virtual-fly/VF_MOTOR_DRIVER/VF_Motor_Driver_rev2/OutputFiles/Assembly/VF_Motor_Driver_BOM.xlsx

Comment | Designator | Footprint | LCSC | Comment | Manufacturer | Reference
74LV17APWJ | U8,U3 | TSSOP-14_4.4x5mm_P0.65mm | C7780 |  | Texas Instruments | SN74LV14APWR
100nF | C27,C18,C25,C26,C65,C56,C57,C55,C9,C23,C66,C17,C24,C28,C54,C34,C59,C29,C43,C4,C67,C35,C53,C40,C30,C60,C12,C48,C6,C68,C58,C36 | C_0603_1608Metric | C14663
ABN Encoder Roll | J7 | JST_PH_B5B-PH-K_1x05_P2.00mm_Vertical | C157993
LM5109BSD | U24,U25,U26,U11,U9,U10 | WSON-8-1EP_4x4mm_P0.8mm_EP2.6x3mm | C544701 |  | Texas Instruments | LM5109BSD/NOPB
MCP1416 | U18,U36 | SOT-23-5 | C83775 |  | Microchip Tech | MCP1416T-E/OT
1.5k | R60,R65,R36,R27,R62,R11 | R_0603_1608Metric | C22843
10uF | C14,C13,C11,C15,C16,C46,C5,C2,C8,C10 | C_0805_2012Metric | C440198
HV>100V | D37 | D_SMA | C5241914 |  | VSSAF5M10-M3/H | VSSAF5M10-M3/H
10k | R1,R37,R38,R15,R53,R44,R54,R40,R43,R42,R29,R16,R24 | R_0603_1608Metric | C25804
0R | R4,R6,R2,R5,R23 | R_0603_1608Metric | C21189 | Mount R23 when using only one brake resistor
ABN Encoder Pitch | J3 | JST_PH_B5B-PH-K_1x05_P2.00mm_Vertical | C157993
BSC030N08NS5ATMA1 | U28,U27,U38,U32,U17,U20,U14,U7,U15,U21,U16,U22,U33,U31,U34,U37 | Infineon_PG-TDSON-8_6.15x5.15mm | C3288905 |  | Infineon Technologies | BSC030N08NS5ATMA1
LV Low Drop | D17,D34,D35,D15,D2 | D_SOD-123F | C130413
LD1117S33TR_SOT223 | U5 | SOT-223-3_TabPin2 | C86781
10uH - LQH43PN100M26L | L1 | L_1812_4532Metric | C99792 |  | Murata Electronics | LQH43PN100M26L
POWER SUPPLY / BRAKE RESISTOR | J6,J2 | JST_VH_B2P-VH-B_1x02_P3.96mm_Vertical |  | 10 A with AWG16 wire. Mating: VHR-2N housing + SVH-41T-P1.1 contacts | JST | B2P-VH-B(LF)(SN)
AP3012KTR-G1 | U2 | SOT-23-5 | C102618
LD1117S50TR_SOT223 | U4 | SOT-223-3_TabPin2 | C134077
Power Led | LED1 | LED_0805_2012Metric | C2297
680uF | C71,C42,C70,C44 | CP_Radial_D16.0mm_P7.50mm | C6611961 |  | PANASONIC | EEU-FS1K681B
ACS724xLCTR-30AB | U29,U13,U12,U30 | SOIC-8_3.9x4.9mm_P1.27mm | C141715 |  | Allegro MicroSystems, LLC | ACS724LLCTR-30AB-T
MOTOR Pitch | J4 | JST_VH_B3P-VH-B_1x03_P3.96mm_Vertical |  | 10 A with AWG16 wire. Mating: VHR-3N housing + SVH-41T-P1.1 contacts | JST | B3P-VH-B(LF)(SN)
220uH | L2 | L_Wurth_WE-LQS-8065 | C86663 |  | Sunlord | SWPA8040S221MT
TMC4671-LA | U23,U1 | QFN76_10P5X6P5_TRI | C465954 | Out of Stock | TRINAMIC Motion Control GmbH | TMC4671-LA
ASCO-25.000MHZ-EK-T3 | Y2,Y1 | Oscillator_SMD_Abracon_ASCO-4Pin_1.6x1.2mm | C7503544
593D(68/47)6X0016D2TE3 | C72 | CP_EIA-7343-31_Kemet-D | C1968403 |  | Vishay Intertech | 593D476X9016D2TE3
MOTOR Roll | J8 | JST_VH_B3P-VH-B_1x03_P3.96mm_Vertical |  | 10 A with AWG16 wire. Mating: VHR-3N housing + SVH-41T-P1.1 contacts | JST | B3P-VH-B(LF)(SN)
MAX5035(D/B)ASA/V+ | U35 | SOIC-8_3.9x4.9mm_P1.27mm | C15940 |  | Analog Devices Inc./Maxim Integrated | MAX5035DASA+T
LV Low drop | D1,D21 | D_SOD-123F | C130413
MCP6004 | U40,U19 | TSSOP-14_4.4x5mm_P0.65mm | C50282
Communication connector | J5 | IDC-Header_2x08_P2.54mm_Vertical | C3406
36k | R34,R51,R30,R52,R25,R33,R55,R63 | R_0603_1608Metric | C103579
1uF | C39,C61,C64,C7,C69,C38,C37,C41,C33 | C_1206_3216Metric | C1848
HV>100V | D12,D29,D11,D19,D28,D13,D30,D3 | D_SOD-123F | C64898
HV>100V | D4 | D_SOD-123F | C604266 |  | onsemi | NRVB1H100SFT3G
10R | R17,R19,R48,R22,R20,R49,R50,R46,R47,R21,R45,R18 | R_0603_1608Metric | C22859
47k | R67,R13,R32 | R_0603_1608Metric | C25819
BZX384-XXX | D14,D18,D32,D16,D33,D31 | D_SOD-323 | C295459
10k thermistor | R26,R61 | R_0603_1608Metric | C525381
4.7uF | C52,C3,C1,C45,C49,C20,C47,C51,C21,C22,C19,C50 | C_0603_1608Metric | C19666
4.7k | R9,R7,R58,R10,R56,R57 | R_0603_1608Metric | C23162
294k | R41,R39,R3 | R_0603_1608Metric | C2999562
D | D27,D10,D5,D22,D7,D9,D23,D8,D6,D25,D24,D26 | D_SOD-123F | C64898
71.5k | R64,R35,R66,R31,R8,R14 | R_0805_2012Metric | C2684592
4.7nF | C62,C31,C32,C63 | C_0603_1608Metric | C53987
LM74700-Q1 | U39,U6 | SOT-23-6 | C2941042
5V | JP2 | R_0805_2012Metric | C17477
15k | R12 | R_0603_1608Metric | C22809
3V3 | JP1 | R_0805_2012Metric | C17477
1M | R68 | R_1206_3216Metric | C17927
100nF 250V | C73 | C_Disc_D7.5mm_W5.0mm_P7.50mm | C342770 |  | TDK | CS45-F2GA103M-VKA
