virtual-fly/VF_MOTOR_DRIVER/VF_Motor_Driver_rev2/OutputFiles/3D/VF_Motor_Driver_rev3.step

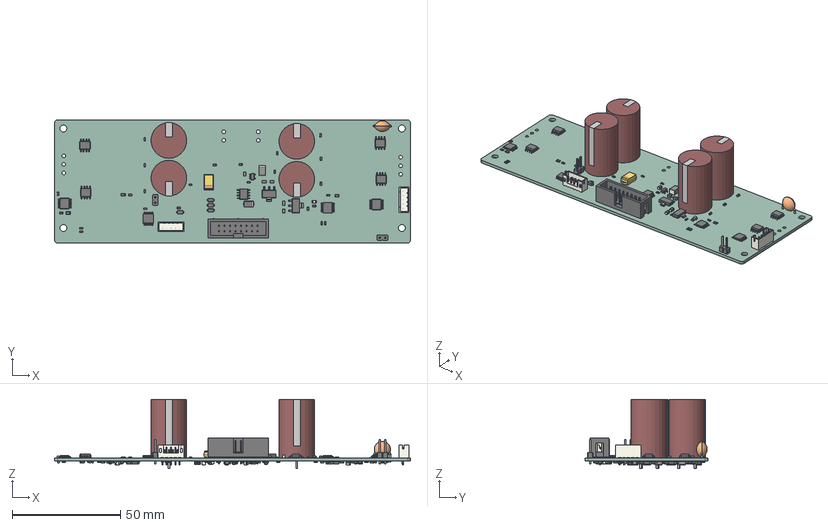
[picture p1: CAD file, 2026-11-05]
VF_Motor_Driver_rev2/OutputFiles/3D/VF_Motor_Driver_rev3.step
164.6 x 57.0 x 32.1 mm
R_0603_1608Metric x 59
JST_PH_B5B-PH-K_1x05_P2.00mm_Vertical x 2
C_0805_2012Metric x 10
D_SMA
C_0603_1608Metric x 48
PinHeader_1x02_P2.54mm_Vertical x 2
TSSOP-14_4.4x5mm_P0.65mm x 4
D_SOD-123F x 28
SOT-223 x 2
L_1812_4532Metric
SOT-23-5 x 3
LED_0805_2012Metric
CAP_EEUFS1K681B_PAN x 4
SOIC-8_3.9x4.9mm_P1.27mm x 5
R_0805_2012Metric x 8
CP_EIA-7343-31_Kemet-D
C_Disc_D7.5mm_W5.0mm_P7.50mm
IDC-Header_2x08_P2.54mm_Vertical
C_1206_3216Metric x 9
D_SOD-323 x 6
R_1206_3216Metric
SOT-23-6 x 2
VF_Motor_Driver_PCB
