virtual-fly/VF_MOTOR_DRIVER/VF_Motor_Driver_rev2/OutputFiles/3D/VF_Motor_Driver_rev2.step

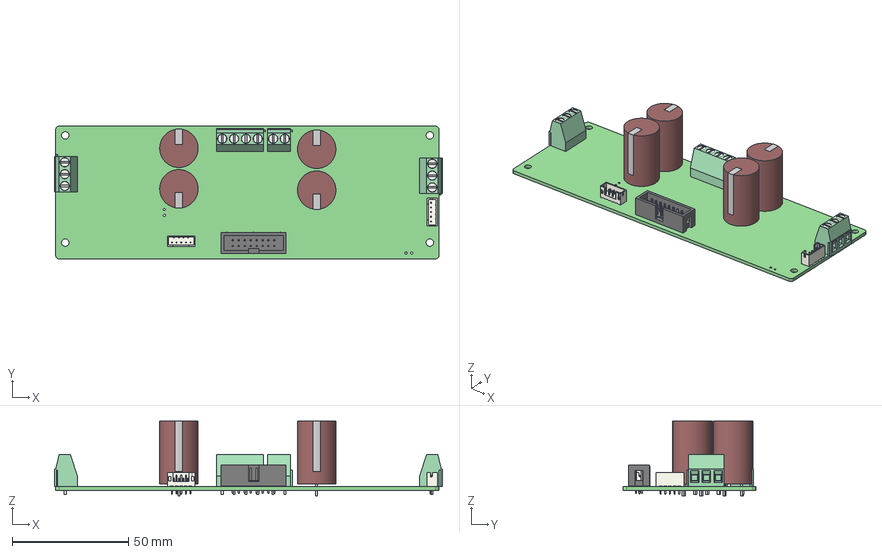
[picture p2: CAD file, 2026-04-09]
VF_Motor_Driver_rev2/OutputFiles/3D/VF_Motor_Driver_rev2.step
166.5 x 57.0 x 32.1 mm
VF_Motor_Driver PCB
