virtual-fly/VF_MOTOR_DRIVER/(list of files, cad)

Other CAD files:
VF_Motor_Driver_rev2/OutputFiles/3D/VF_Motor_Driver_rev2.1.step
