virtual-fly/VF_MOTOR_DRIVER/VF_Motor_Driver_rev2/OutputFiles/FR4_Characteristics.PNG

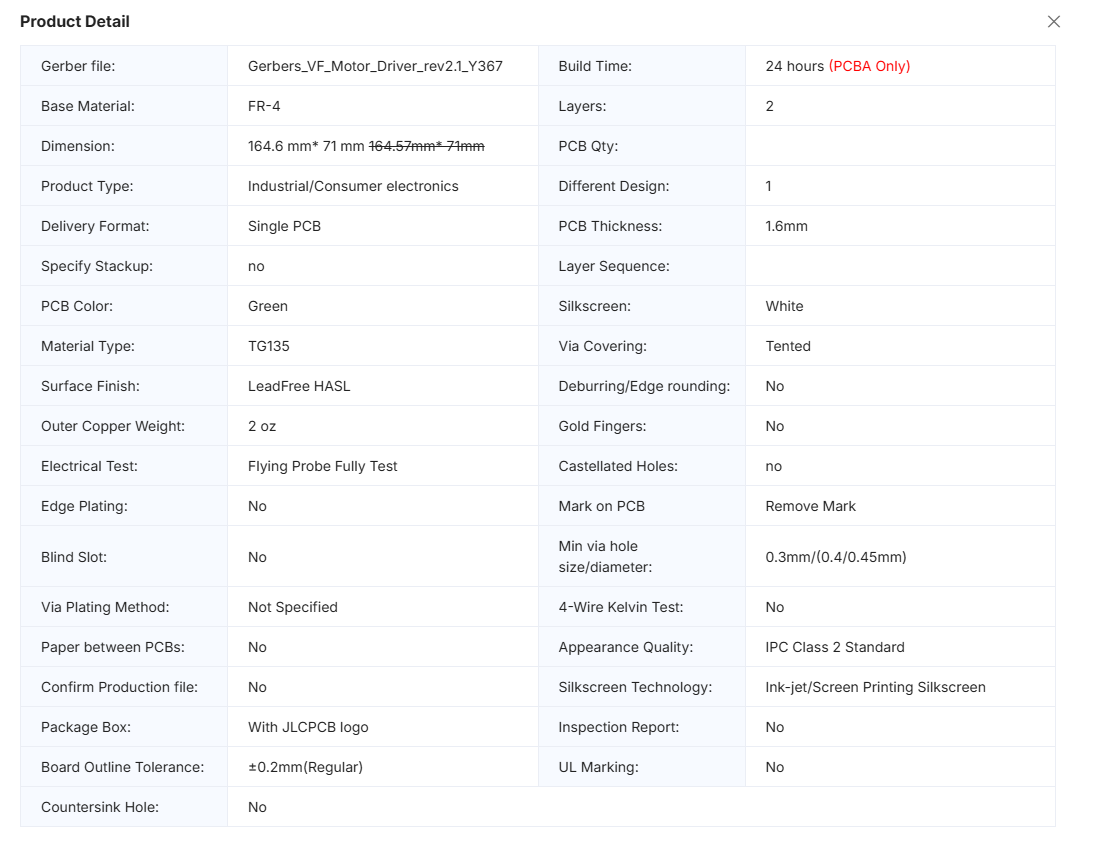
VF_Motor_Driver_rev2/OutputFiles/FR4_Characteristics.PNG
