virtual-fly/VF_MOTOR_DRIVER/VF_Motor_Driver_rev2/OutputFiles/Schematic/VF_Motor_Driver.pdf

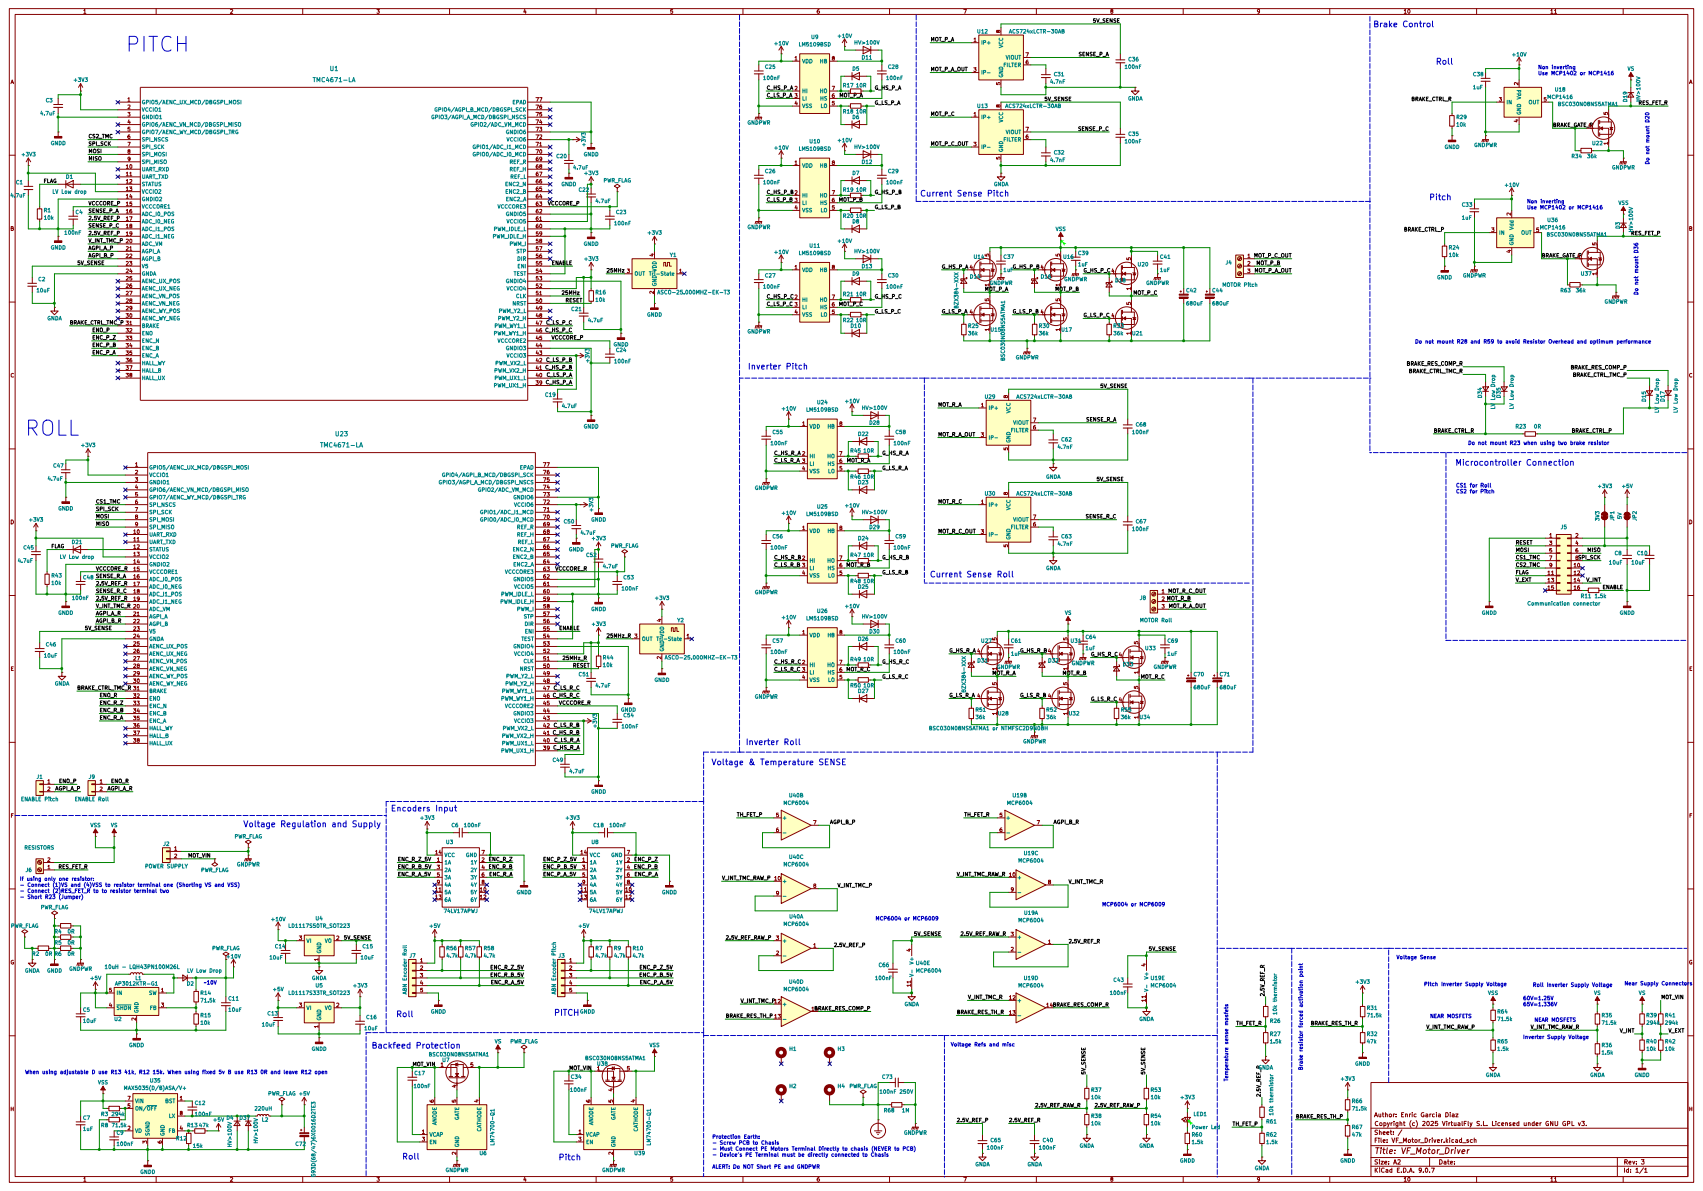
[picture p4: page 1]
