virtual-fly/VF_MOTOR_DRIVER/VF_Motor_Driver_rev2/VF_Motor_Driver.kicad_pcb

## KiCad design VF_Motor_Driver_rev2/VF_Motor_Driver.kicad_pcb (2026-11-05)

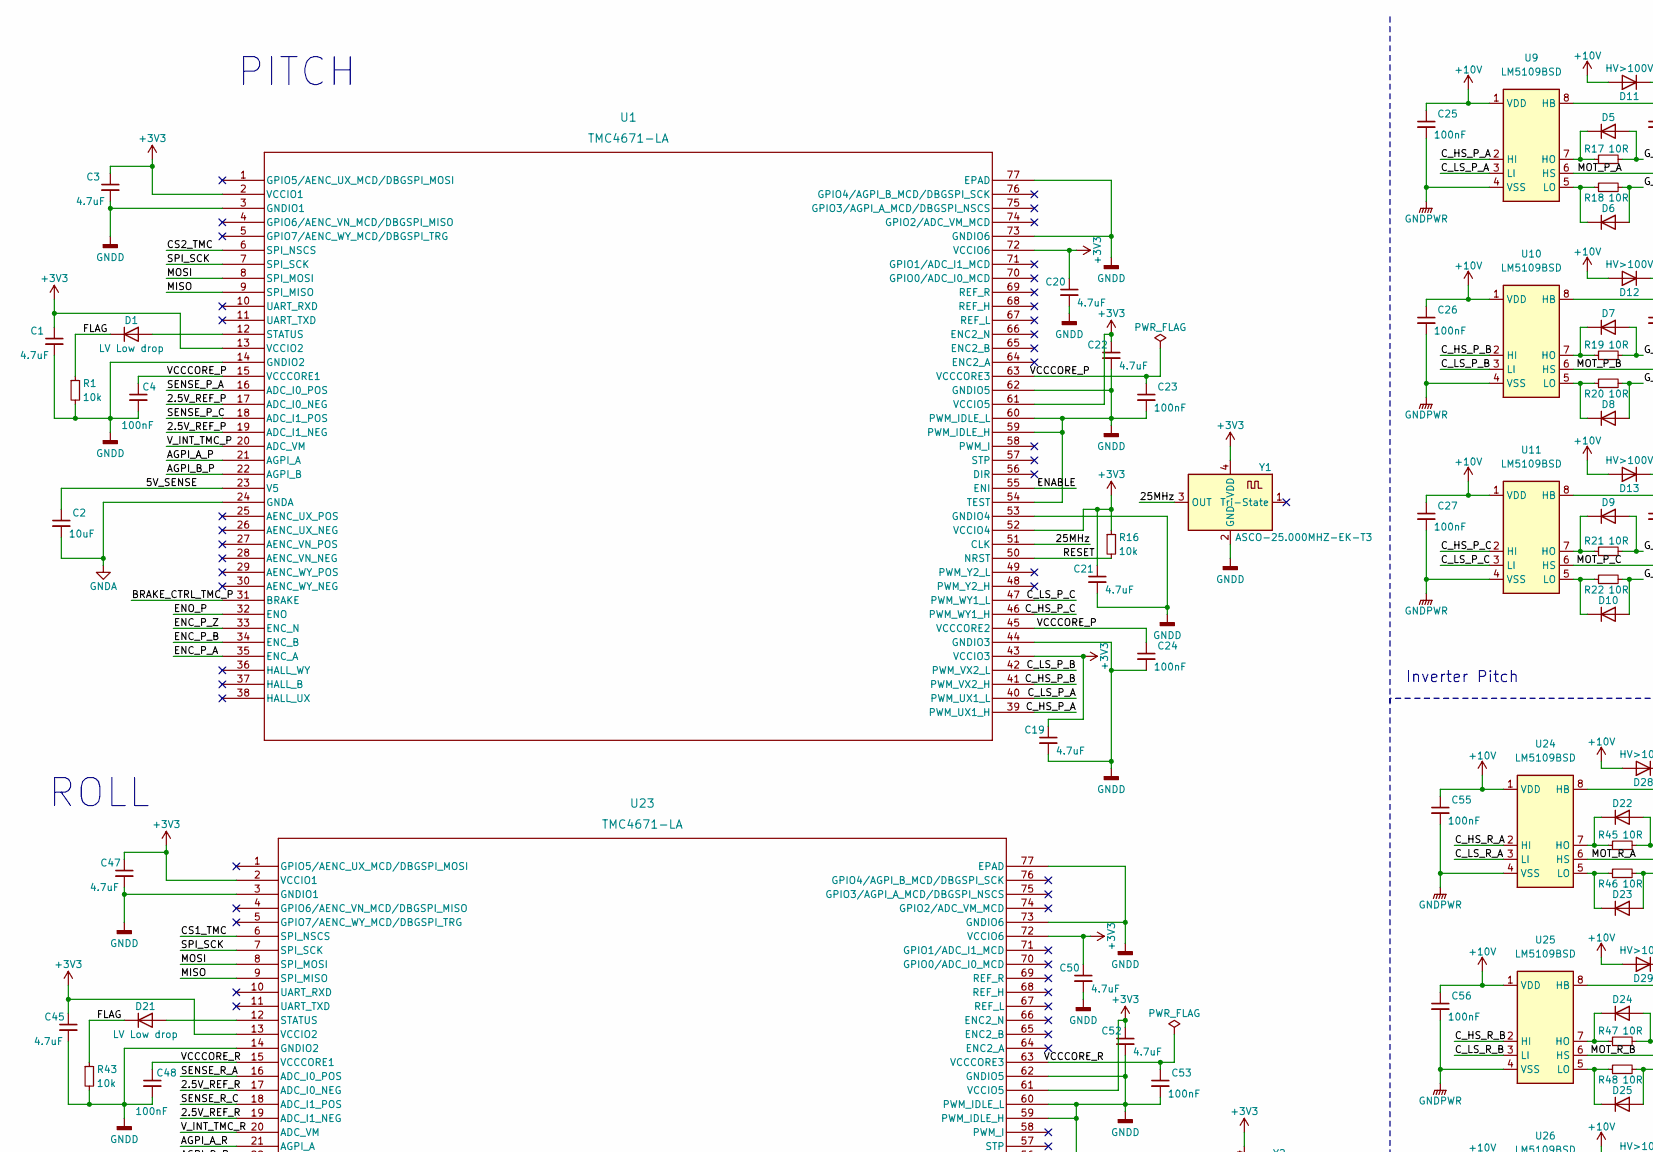
[picture p23: schematic VF_Motor_Driver.kicad_sch, part in row 1, column 1]

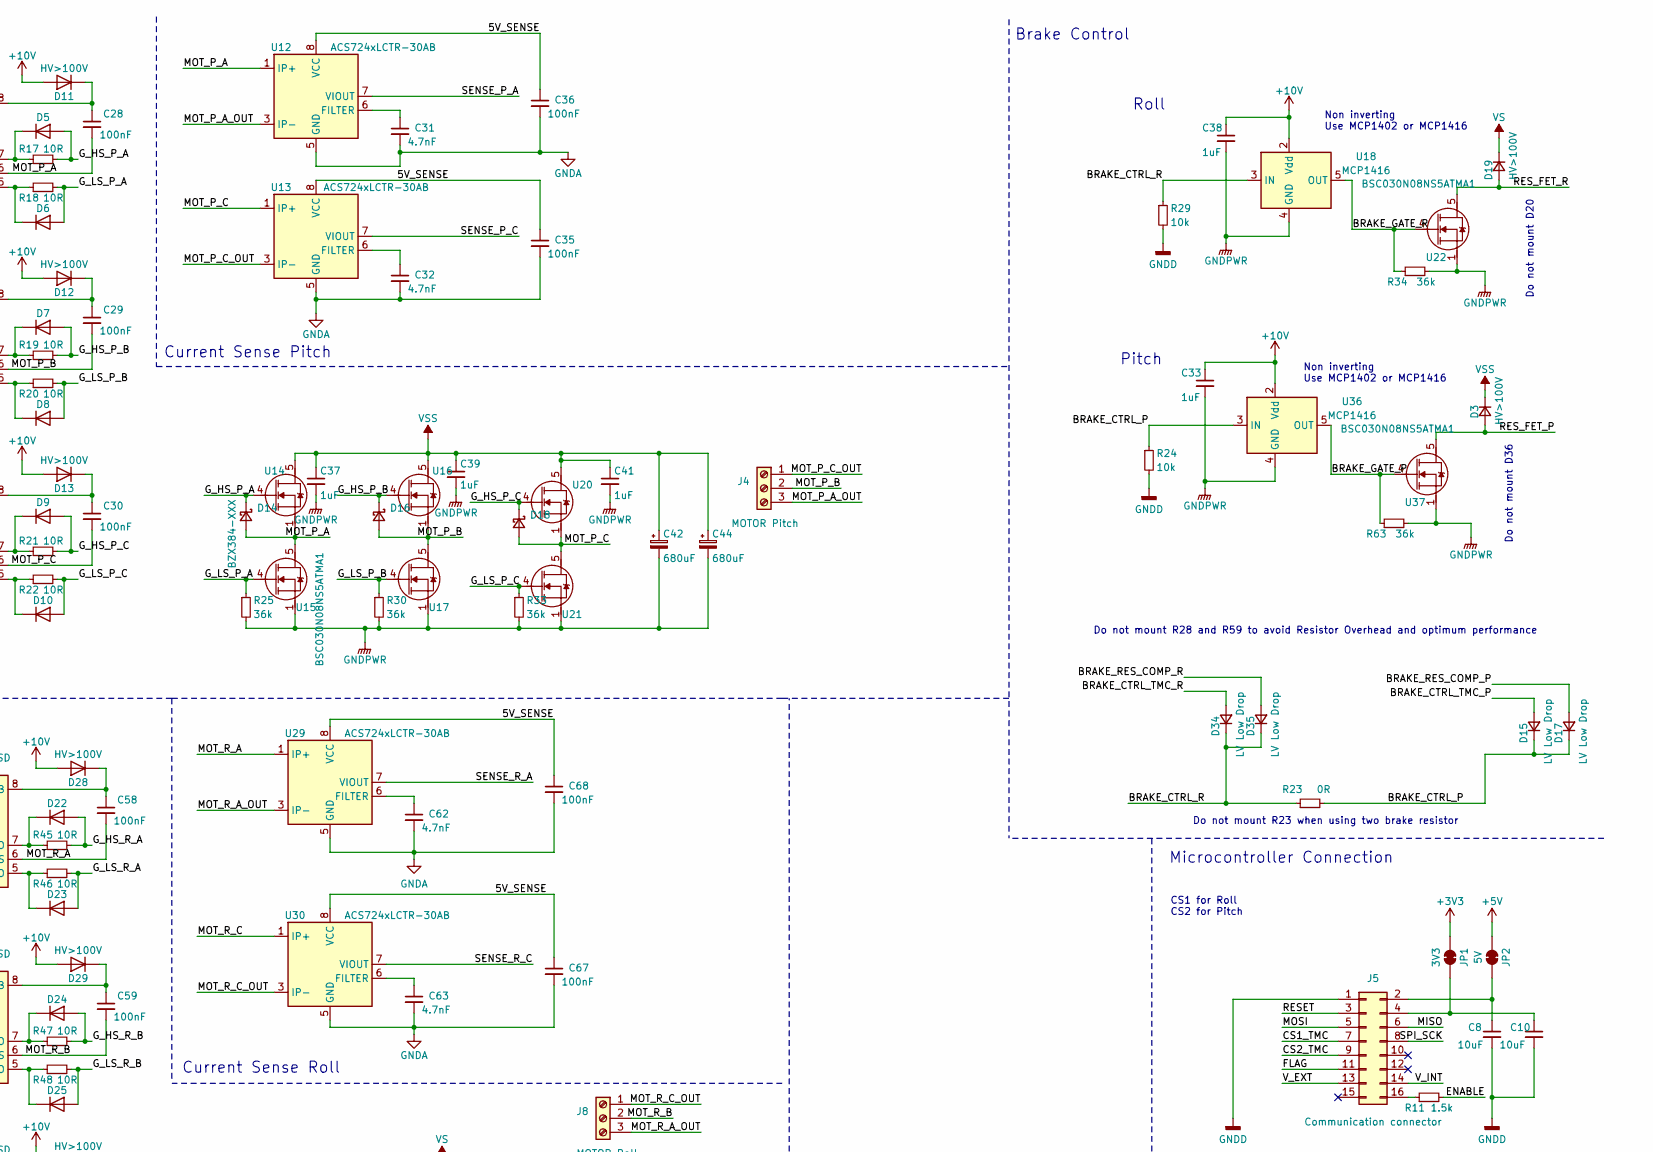
[picture p24: schematic VF_Motor_Driver.kicad_sch, part in row 1, column 2]

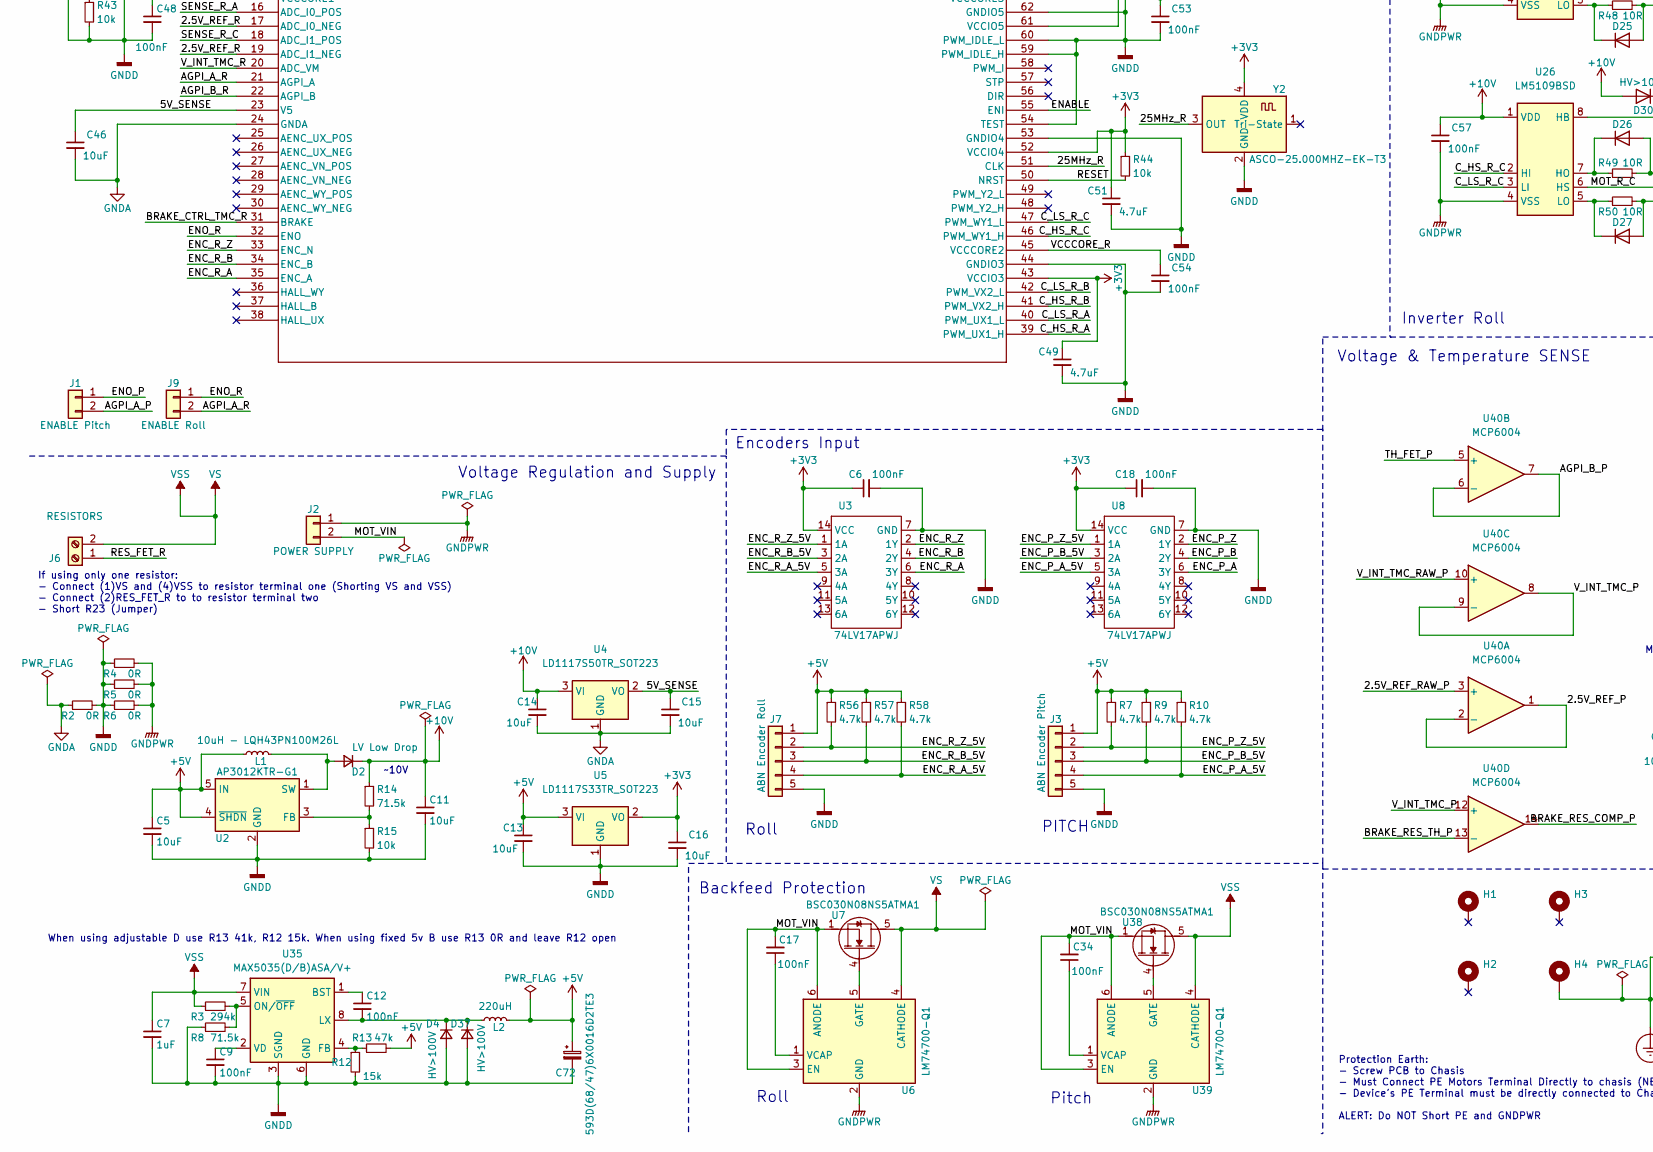
[picture p25: schematic VF_Motor_Driver.kicad_sch, part in row 2, column 1]

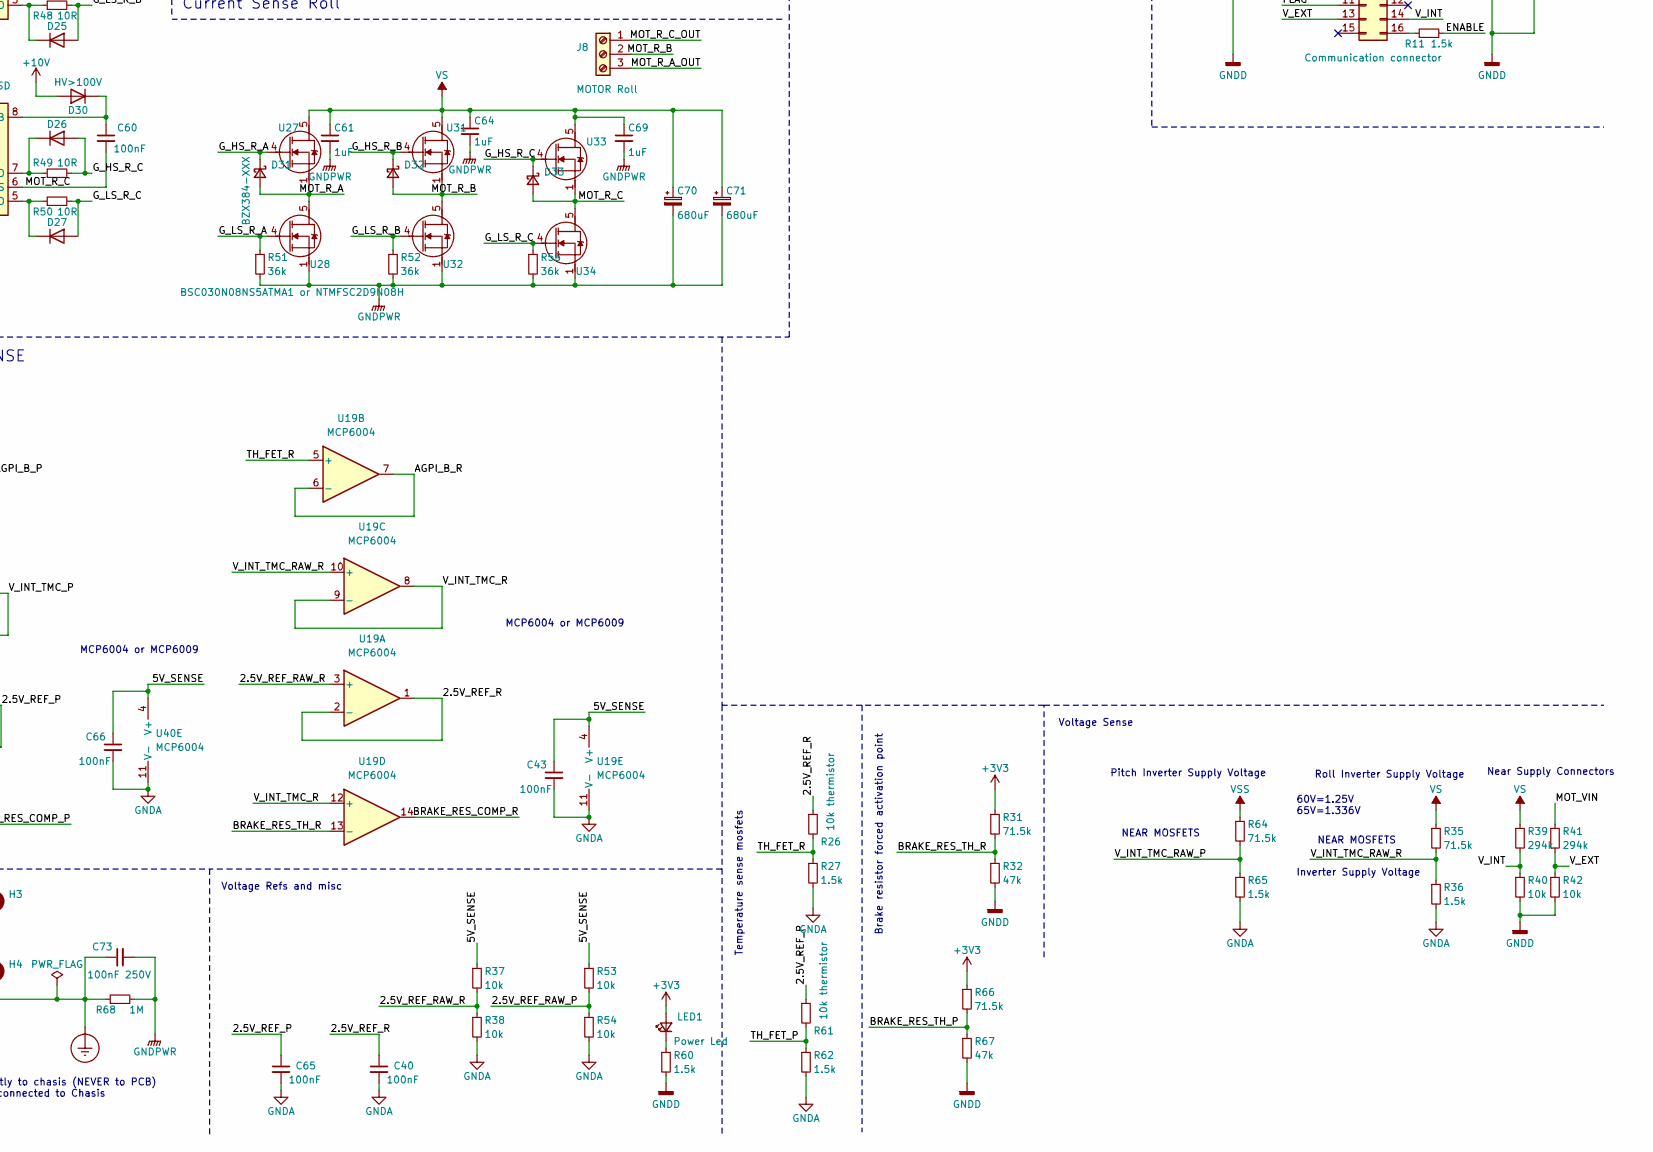
[picture p26: schematic VF_Motor_Driver.kicad_sch, part in row 2, column 2]

Parts:
C1, C3, C19, C20, C21, C22, C45, C47, C49, C50, C51, C52: 4.7uF; C_0603_1608Metric
C2, C5, C8, C10, C11, C13, C14, C15, C16, C46: 10uF; C_0805_2012Metric
C4, C6, C9, C12, C17, C18, C23, C24, C25, C26, C27, C28, C29, C30, C34, C35, C36, C40, C43, C48, C53, C54, C55, C56, C57, C58, C59, C60, C65, C66, C67, C68: 100nF; C_0603_1608Metric
C7, C33, C37, C38, C39, C41, C61, C64, C69: 1uF; C_1206_3216Metric
C31, C32, C62, C63: 4.7nF; C_0603_1608Metric
C42, C44, C70, C71: 680uF; CP_Radial_D16.0mm_P7.50mm
C72: 593D(68/47)6X0016D2TE3; CP_EIA-7343-31_Kemet-D
C73: 100nF 250V; C_Disc_D7.5mm_W5.0mm_P7.50mm; JLCPCB C342770
D1, D21: LV Low drop; D_SOD-123F
D2, D15, D17, D34, D35: LV Low Drop; D_SOD-123F
D3, D4, D11, D12, D13, D19, D28, D29, D30: HV>100V; D_SOD-123F
D5, D6, D7, D8, D9, D10, D22, D23, D24, D25, D26, D27: D; D_SOD-123F
D14, D16, D18, D31, D32, D33: BZX384-XXX; D_SOD-323
D37: HV>100V; D_SMA
H1, H2, H3, H4: MountingHole_Pad; MountingHole_3.2mm_M3_Pad
J1: ENABLE Pitch; PinHeader_1x02_P2.54mm_Vertical
J2: POWER SUPPLY; JST_VH_B2P-VH-B_1x02_P3.96mm_Vertical
J3: ABN Encoder Pitch; JST_PH_B5B-PH-K_1x05_P2.00mm_Vertical; JLCPCB C157993
J4: MOTOR Pitch; JST_VH_B3P-VH-B_1x03_P3.96mm_Vertical; JLCPCB C72334
J5: Communication connector; IDC-Header_2x08_P2.54mm_Vertical
J6: RESISTORS; JST_VH_B2P-VH-B_1x02_P3.96mm_Vertical
J7: ABN Encoder Roll; JST_PH_B5B-PH-K_1x05_P2.00mm_Vertical
J8: MOTOR Roll; JST_VH_B3P-VH-B_1x03_P3.96mm_Vertical; JLCPCB C72334
J9: ENABLE Roll; PinHeader_1x02_P2.54mm_Vertical
JP1: 3V3; R_0805_2012Metric
JP2: 5V; R_0805_2012Metric
L1: 10uH - LQH43PN100M26L; L_1812_4532Metric; JLCPCB C99792
L2: 220uH; L_Wurth_WE-LQS-8065
LED1: Power Led; LED_0805_2012Metric; JLCPCB C2297
R1, R15, R16, R24, R29, R37, R38, R40, R42, R43, R44, R53, R54: 10k; R_0603_1608Metric
R2, R4, R5, R6, R23: 0R; R_0603_1608Metric
R3, R39, R41: 294k; R_0603_1608Metric
R7, R9, R10, R56, R57, R58: 4.7k; R_0603_1608Metric
R8, R14, R31, R35, R64, R66: 71.5k; R_0805_2012Metric
R11, R27, R36, R60, R62, R65: 1.5k; R_0603_1608Metric
R12: 15k; R_0603_1608Metric
R13, R32, R67: 47k; R_0603_1608Metric
R17, R18, R19, R20, R21, R22, R45, R46, R47, R48, R49, R50: 10R; R_0603_1608Metric
R25, R30, R33, R34, R51, R52, R55, R63: 36k; R_0603_1608Metric
R26, R61: 10k thermistor; R_0603_1608Metric
R68: 1M; R_1206_3216Metric; JLCPCB C17927
U1, U23: TMC4671-LA; QFN76_10P5X6P5_TRI
U2: AP3012KTR-G1; SOT-23-5
U3, U8: 74LV17APWJ; TSSOP-14_4.4x5mm_P0.65mm
U4: LD1117S50TR_SOT223; SOT-223-3_TabPin2
U5: LD1117S33TR_SOT223; SOT-223-3_TabPin2
U6, U39: LM74700-Q1; SOT-23-6
U7, U14, U15, U16, U17, U20, U21, U22, U27, U31, U32, U33, U34, U37, U38: BSC030N08NS5ATMA1; Infineon_PG-TDSON-8_6.15x5.15mm
U9, U10, U11, U24, U25, U26: LM5109BSD; WSON-8-1EP_4x4mm_P0.8mm_EP2.6x3mm
U12, U13, U29, U30: ACS724xLCTR-30AB; SOIC-8_3.9x4.9mm_P1.27mm
U18, U36: MCP1416; SOT-23-5
U19, U40: MCP6004; TSSOP-14_4.4x5mm_P0.65mm
U28: BSC030N08NS5ATMA1 or NTMFSC2D9N08H; Infineon_PG-TDSON-8_6.15x5.15mm
U35: MAX5035(D/B)ASA/V+; SOIC-8_3.9x4.9mm_P1.27mm
Y1, Y2: ASCO-25.000MHZ-EK-T3; Oscillator_SMD_Abracon_ASCO-4Pin_1.6x1.2mm

Connections:
+3V3: C1.1, C3.1, C6.1, C16.1, C18.1, C19.1, C20.1, C21.1, C22.1, C45.1, C47.1, C49.1, C50.1, C51.1, C52.1, JP1.2 (B), LED1.2 (A), R16.1, R31.1, R44.1, R66.1, U1.2 (VCCIO1), U1.13 (VCCIO2), U1.43 (VCCIO3), U1.52 (VCCIO4), U1.61 (VCCIO5), U1.72 (VCCIO6), U3.14 (VCC), U5.2 (VO), U8.14 (VCC), U23.2 (VCCIO1), U23.13 (VCCIO2), U23.43 (VCCIO3), U23.52 (VCCIO4), U23.61 (VCCIO5), U23.72 (VCCIO6), Y1.4 (VDD), Y2.4 (VDD)
+5V: C5.1, C13.1, C72.1, J3.1, J7.1, JP2.2 (B), L1.1, L2.2, R7.1, R9.1, R10.1, R13.2, R56.1, R57.1, R58.1, U2.4 (~SHDN), U2.5 (IN), U5.3 (VI)
+10V: C11.1, C14.1, C25.1, C26.1, C27.1, C33.1, C38.1, C55.1, C56.1, C57.1, D2.1 (K), D11.2 (A), D12.2 (A), D13.2 (A), D28.2 (A), D29.2 (A), D30.2 (A), R14.1, U4.3 (VI), U9.1 (VDD), U10.1 (VDD), U11.1 (VDD), U18.2 (Vdd), U24.1 (VDD), U25.1 (VDD), U26.1 (VDD), U36.2 (Vdd)
/2.5V_REF_P: C65.1, R61.1, U1.17 (ADC_I0_NEG), U1.19 (ADC_I1_NEG), U40.1, U40.2 (-)
/2.5V_REF_R: C40.1, R26.1, U19.1, U19.2 (-), U23.17 (ADC_I0_NEG), U23.19 (ADC_I1_NEG)
/2.5V_REF_RAW_P: R53.2, R54.1, U40.3 (+)
/2.5V_REF_RAW_R: R37.2, R38.1, U19.3 (+)
/5V_SENSE: C2.1, C15.1, C35.1, C36.1, C43.1, C46.1, C66.1, C67.1, C68.1, R37.1, R53.1, U1.23 (V5), U4.2 (VO), U12.8 (VCC), U13.8 (VCC), U19.4 (V+), U23.23 (V5), U29.8 (VCC), U30.8 (VCC), U40.4 (V+)
/25MHz: U1.51 (CLK), Y1.3 (OUT)
/25MHz_R: U23.51 (CLK), Y2.3 (OUT)
/AGPI_A_P: J1.2, U1.21 (AGPI_A)
/AGPI_A_R: J9.2, U23.21 (AGPI_A)
/AGPI_B_P: U1.22 (AGPI_B), U40.6 (-), U40.7
/AGPI_B_R: U19.6 (-), U19.7, U23.22 (AGPI_B)
/BRAKE_CTRL_P: D15.1 (K), D17.1 (K), R23.2, R24.1, U36.3 (IN)
/BRAKE_CTRL_R: D34.1 (K), D35.1 (K), R23.1, R29.1, U18.3 (IN)
/BRAKE_CTRL_TMC_P: D15.2 (A), U1.31 (BRAKE)
/BRAKE_CTRL_TMC_R: D34.2 (A), U23.31 (BRAKE)
/BRAKE_GATE_P: R63.1, U36.5 (OUT), U37.4
/BRAKE_GATE_R: R34.1, U18.5 (OUT), U22.4
/BRAKE_RES_COMP_P: D17.2 (A), U40.14
/BRAKE_RES_COMP_R: D35.2 (A), U19.14
/BRAKE_RES_TH_P: R66.2, R67.1, U40.13 (-)
/BRAKE_RES_TH_R: R31.2, R32.1, U19.13 (-)
/CS1_TMC: J5.7, U23.6 (SPI_NSCS)
/CS2_TMC: J5.9, U1.6 (SPI_NSCS)
/C_HS_P_A: U1.39 (PWM_UX1_H), U9.2 (HI)
/C_HS_P_B: U1.41 (PWM_VX2_H), U10.2 (HI)
/C_HS_P_C: U1.46 (PWM_WY1_H), U11.2 (HI)
/C_HS_R_A: U23.39 (PWM_UX1_H), U24.2 (HI)
/C_HS_R_B: U23.41 (PWM_VX2_H), U25.2 (HI)
/C_HS_R_C: U23.46 (PWM_WY1_H), U26.2 (HI)
/C_LS_P_A: U1.40 (PWM_UX1_L), U9.3 (LI)
/C_LS_P_B: U1.42 (PWM_VX2_L), U10.3 (LI)
/C_LS_P_C: U1.47 (PWM_WY1_L), U11.3 (LI)
/C_LS_R_A: U23.40 (PWM_UX1_L), U24.3 (LI)
/C_LS_R_B: U23.42 (PWM_VX2_L), U25.3 (LI)
/C_LS_R_C: U23.47 (PWM_WY1_L), U26.3 (LI)
/ENABLE: R11.2, U1.55 (ENI), U23.55 (ENI)
/ENC_P_A: U1.35 (ENC_A), U8.6 (3Y)
/ENC_P_A_5V: J3.4, R10.2, U8.5 (3A)
/ENC_P_B: U1.34 (ENC_B), U8.4 (2Y)
/ENC_P_B_5V: J3.3, R9.2, U8.3 (2A)
/ENC_P_Z: U1.33 (ENC_N), U8.2 (1Y)
/ENC_P_Z_5V: J3.2, R7.2, U8.1 (1A)
/ENC_R_A: U3.6 (3Y), U23.35 (ENC_A)
/ENC_R_A_5V: J7.4, R58.2, U3.5 (3A)
/ENC_R_B: U3.4 (2Y), U23.34 (ENC_B)
/ENC_R_B_5V: J7.3, R57.2, U3.3 (2A)
/ENC_R_Z: U3.2 (1Y), U23.33 (ENC_N)
/ENC_R_Z_5V: J7.2, R56.2, U3.1 (1A)
/ENO_P: J1.1, U1.32 (ENO)
/ENO_R: J9.1, U23.32 (ENO)
/FLAG: D1.1 (K), D21.1 (K), J5.11, R1.1, R43.1
/G_HS_P_A: D5.2 (A), D14.1 (K), R17.2, U14.4
/G_HS_P_B: D7.2 (A), D16.1 (K), R19.2, U16.4
/G_HS_P_C: D9.2 (A), D18.1 (K), R21.2, U20.4
/G_HS_R_A: D22.2 (A), D31.1 (K), R45.2, U27.4
/G_HS_R_B: D24.2 (A), D32.1 (K), R47.2, U31.4
/G_HS_R_C: D26.2 (A), D33.1 (K), R49.2, U33.4
/G_LS_P_A: D6.2 (A), R18.2, R25.1, U15.4
/G_LS_P_B: D8.2 (A), R20.2, R30.1, U17.4
/G_LS_P_C: D10.2 (A), R22.2, R33.1, U21.4
/G_LS_R_A: D23.2 (A), R46.2, R51.1, U28.4
/G_LS_R_B: D25.2 (A), R48.2, R52.1, U32.4
/G_LS_R_C: D27.2 (A), R50.2, R55.1, U34.4
/MISO: J5.6, U1.9 (SPI_MISO), U23.9 (SPI_MISO)
/MOSI: J5.5, U1.8 (SPI_MOSI), U23.8 (SPI_MOSI)
/MOT_P_A: C28.2, D14.2 (A), U9.6 (HS), U12.1 (IP+), U12.2 (IP+), U14.1, U14.2 (S), U14.3 (S), U15.5
/MOT_P_A_OUT: J4.3, U12.3 (IP-), U12.4 (IP-)
/MOT_P_B: C29.2, D16.2 (A), J4.2, U10.6 (HS), U16.1, U16.2 (S), U16.3 (S), U17.5
/MOT_P_C: C30.2, D18.2 (A), U11.6 (HS), U13.1 (IP+), U13.2 (IP+), U20.1, U20.2 (S), U20.3 (S), U21.5
/MOT_P_C_OUT: J4.1, U13.3 (IP-), U13.4 (IP-)
/MOT_R_A: C58.2, D31.2 (A), U24.6 (HS), U27.1, U27.2 (S), U27.3 (S), U28.5, U29.1 (IP+), U29.2 (IP+)
/MOT_R_A_OUT: J8.3, U29.3 (IP-), U29.4 (IP-)
/MOT_R_B: C59.2, D32.2 (A), J8.2, U25.6 (HS), U31.1, U31.2 (S), U31.3 (S), U32.5
/MOT_R_C: C60.2, D33.2 (A), U26.6 (HS), U30.1 (IP+), U30.2 (IP+), U33.1, U33.2 (S), U33.3 (S), U34.5
/MOT_R_C_OUT: J8.1, U30.3 (IP-), U30.4 (IP-)
/MOT_VIN: C17.2, C34.2, J2.2, R41.1, U6.3 (EN), U6.6 (ANODE), U7.1, U7.2 (S), U7.3 (S), U38.1, U38.2 (S), U38.3 (S), U39.3 (EN), U39.6 (ANODE)
/RESET: J5.3, R16.2, R44.2, U1.50 (NRST), U23.50 (NRST)
/RES_FET_P: D3.2 (A), U37.5
/RES_FET_R: D19.2 (A), J6.1, U22.5
/SENSE_P_A: U1.16 (ADC_I0_POS), U12.7 (VIOUT)
/SENSE_P_C: U1.18 (ADC_I1_POS), U13.7 (VIOUT)
/SENSE_R_A: U23.16 (ADC_I0_POS), U29.7 (VIOUT)
/SENSE_R_C: U23.18 (ADC_I1_POS), U30.7 (VIOUT)
/SPI_SCK: J5.8, U1.7 (SPI_SCK), U23.7 (SPI_SCK)
/TH_FET_P: R61.2, R62.1, U40.5 (+)
/TH_FET_R: R26.2, R27.1, U19.5 (+)
/VCCCORE_P: C4.1, C23.1, C24.1, U1.15 (VCCCORE1), U1.45 (VCCCORE2), U1.63 (VCCCORE3)
/VCCCORE_R: C48.1, C53.1, C54.1, U23.15 (VCCCORE1), U23.45 (VCCCORE2), U23.63 (VCCCORE3)
/V_EXT: J5.13, R41.2, R42.1
/V_INT: J5.14, R39.2, R40.1
/V_INT_TMC_P: U1.20 (ADC_VM), U40.8, U40.9 (-), U40.12 (+)
/V_INT_TMC_R: U19.8, U19.9 (-), U19.12 (+), U23.20 (ADC_VM)
/V_INT_TMC_RAW_P: R64.2, R65.1, U40.10 (+)
/V_INT_TMC_RAW_R: R35.2, R36.1, U19.10 (+)
Earth_Protective: C73.1, H4.1, R68.1
GNDA: C2.2, C14.2, C15.2, C31.2, C32.2, C35.2, C36.2, C40.2, C43.2, C46.2, C62.2, C63.2, C65.2, C66.2, C67.2, C68.2, R2.1, R27.2, R36.2, R38.2, R54.2, R62.2, R65.2, U1.24 (GNDA), U4.1 (GND), U12.5 (GND), U13.5 (GND), U19.11 (V-), U23.24 (GNDA), U29.5 (GND), U30.5 (GND), U40.11 (V-)
GNDD: C1.2, C3.2, C4.2, C5.2, C6.2, C7.2, C8.2, C9.2, C10.2, C11.2, C13.2, C16.2, C18.2, C19.2, C20.2, C21.2, C22.2, C23.2, C24.2, C45.2, C47.2, C48.2, C49.2, C50.2, C51.2, C52.2, C53.2, C54.2, C72.2, D4.2 (A), D37.2 (A), J3.5, J5.1, J7.5, R1.2, R2.2, R4.1, R5.1, R6.1, R8.1, R12.2, R15.2, R24.2, R29.2, R32.2, R40.2, R42.2, R43.2, R60.2, R67.2, U1.3 (GNDIO1), U1.14 (GNDIO2), U1.44 (GNDIO3), U1.53 (GNDIO4), U1.54 (TEST), U1.59 (PWM_IDLE_H), U1.60 (PWM_IDLE_L), U1.62 (GNDIO5), U1.73 (GNDIO6), U1.77 (EPAD), U2.2 (GND), U3.7 (GND), U5.1 (GND), U8.7 (GND), U23.3 (GNDIO1), U23.14 (GNDIO2), U23.44 (GNDIO3), U23.53 (GNDIO4), U23.54 (TEST), U23.59 (PWM_IDLE_H), U23.60 (PWM_IDLE_L), U23.62 (GNDIO5), U23.73 (GNDIO6), U23.77 (EPAD), U35.3 (SGND), U35.6 (GND), Y1.2 (GND), Y2.2 (GND)
GNDPWR: C25.2, C26.2, C27.2, C33.2, C37.2, C38.2, C39.2, C41.2, C42.2, C44.2, C55.2, C56.2, C57.2, C61.2, C64.2, C69.2, C70.2, C71.2, C73.2, J2.1, R4.2, R5.2, R6.2, R25.2, R30.2, R33.2, R34.2, R51.2, R52.2, R55.2, R63.2, R68.2, U6.2 (GND), U9.4 (VSS), U9.9 (VSS), U10.4 (VSS), U10.9 (VSS), U11.4 (VSS), U11.9 (VSS), U15.1, U15.2 (S), U15.3 (S), U17.1, U17.2 (S), U17.3 (S), U18.4 (GND), U21.1, U21.2 (S), U21.3 (S), U22.1, U22.2 (S), U22.3 (S), U24.4 (VSS), U24.9 (VSS), U25.4 (VSS), U25.9 (VSS), U26.4 (VSS), U26.9 (VSS), U28.1, U28.2 (S), U28.3 (S), U32.1, U32.2 (S), U32.3 (S), U34.1, U34.2 (S), U34.3 (S), U36.4 (GND), U37.1, U37.2 (S), U37.3 (S), U39.2 (GND)
unnamed: D1.2 (A), U1.12 (STATUS)
unnamed: D2.2 (A), L1.2, U2.1 (SW)
unnamed: D5.1 (K), R17.1, U9.7 (HO)
unnamed: D6.1 (K), R18.1, U9.5 (LO)
unnamed: D7.1 (K), R19.1, U10.7 (HO)
unnamed: D8.1 (K), R20.1, U10.5 (LO)
unnamed: D9.1 (K), R21.1, U11.7 (HO)
unnamed: D10.1 (K), R22.1, U11.5 (LO)
unnamed: C28.1, D11.1 (K), U9.8 (HB)
unnamed: C29.1, D12.1 (K), U10.8 (HB)
unnamed: C30.1, D13.1 (K), U11.8 (HB)
unnamed: D21.2 (A), U23.12 (STATUS)
unnamed: D22.1 (K), R45.1, U24.7 (HO)
unnamed: D23.1 (K), R46.1, U24.5 (LO)
unnamed: D24.1 (K), R47.1, U25.7 (HO)
unnamed: D25.1 (K), R48.1, U25.5 (LO)
unnamed: D26.1 (K), R49.1, U26.7 (HO)
unnamed: D27.1 (K), R50.1, U26.5 (LO)
unnamed: C58.1, D28.1 (K), U24.8 (HB)
unnamed: C59.1, D29.1 (K), U25.8 (HB)
unnamed: C60.1, D30.1 (K), U26.8 (HB)
unnamed: C12.2, D4.1 (K), D37.1 (K), L2.1, U35.8 (LX)
unnamed: C8.1, J5.2, JP2.1 (A)
unnamed: C10.1, J5.4, JP1.1 (A)
unnamed: J5.16, R11.1
unnamed: LED1.1 (K), R60.1
unnamed: R14.2, R15.1, U2.3 (FB)
unnamed: U6.5 (GATE), U7.4
unnamed: C17.1, U6.1 (VCAP)
unnamed: C31.1, U12.6 (FILTER)
unnamed: C32.1, U13.6 (FILTER)
unnamed: C62.1, U29.6 (FILTER)
unnamed: C63.1, U30.6 (FILTER)
unnamed: C12.1, U35.1 (BST)
unnamed: R12.1, R13.1, U35.4 (FB)
unnamed: R3.2, R8.2, U35.5 (ON/~OFF)
unnamed: C9.1, U35.2 (VD)
unnamed: U38.4, U39.5 (GATE)
unnamed: C34.1, U39.1 (VCAP)
VS: C7.1, C37.1, C39.1, C41.1, C42.1, C44.1, C61.1, C64.1, C69.1, C70.1, C71.1, D3.1 (K), D19.1 (K), J6.2, R3.1, R35.1, R39.1, R64.1, U6.4 (CATHODE), U7.5, U14.5, U16.5, U20.5, U27.5, U31.5, U33.5, U35.7 (VIN), U38.5, U39.4 (CATHODE)

Notes on the sheet:
Do not mount R23 when using two brake resistor
Brake Control
Backfeed Protection
When using adjustable D use R13 41k, R12 15k. When using fixed 5v B use R13 0R and leave R12 open
Temperature sense mosfets
PITCH
ROLL
CS1 for Roll CS2 for Pitch
Voltage Refs and misc
Pitch
Do not mount D20
Voltage Sense
60V=1.25V 65V=1.336V
Do not mount R28 and R59 to avoid Resistor Overhead and optimum performance
Roll
If using only one resistor: - Connect (1)VS and (4)VSS to resistor terminal one (Shorting VS and VSS) - Connect (2)RES_FET_R to to resistor terminal two - Short R23 (Jumper)
Non inverting Use MCP1402 or MCP1416
Current Sense Pitch
NEAR MOSFETS
Roll Inverter Supply Voltage
Pitch Inverter Supply Voltage
Do not mount D36
Protection Earth: - Screw PCB to Chasis - Must Connect PE Motors Terminal Directly to chasis (NEVER to PCB) - Device's PE Terminal must be directly connected to Chasis ALERT: Do NOT Short PE and GNDPWR
Encoders Input
Inverter Pitch
Voltage & Temperature SENSE
MCP6004 or MCP6009
Inverter Roll
Current Sense Roll
Near Supply Connectors
Voltage Regulation and Supply
Microcontroller Connection
Brake resistor forced activation point
~10V
Inverter Supply Voltage

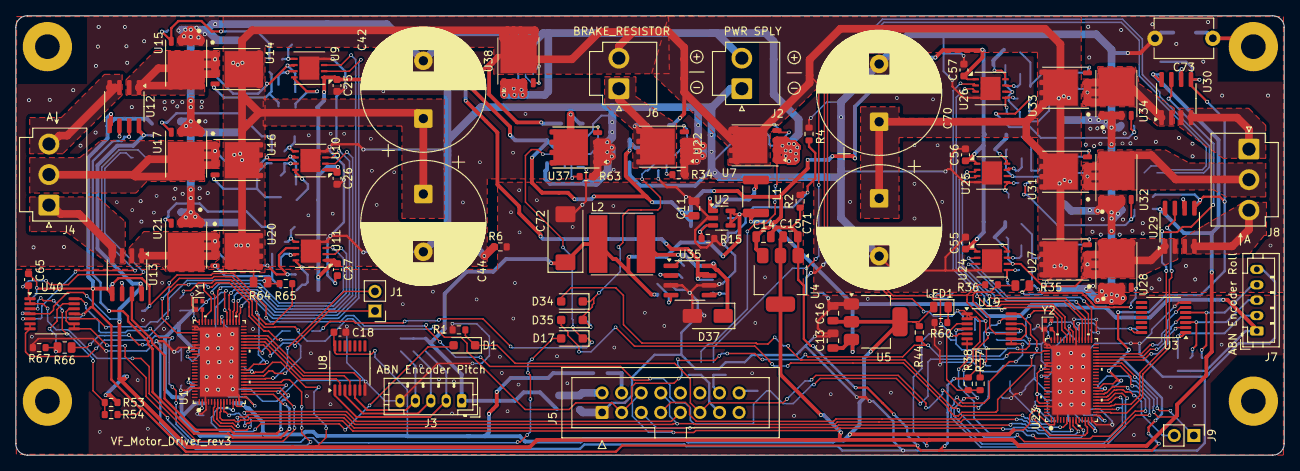
[picture p27: board VF_Motor_Driver.kicad_pcb from above]

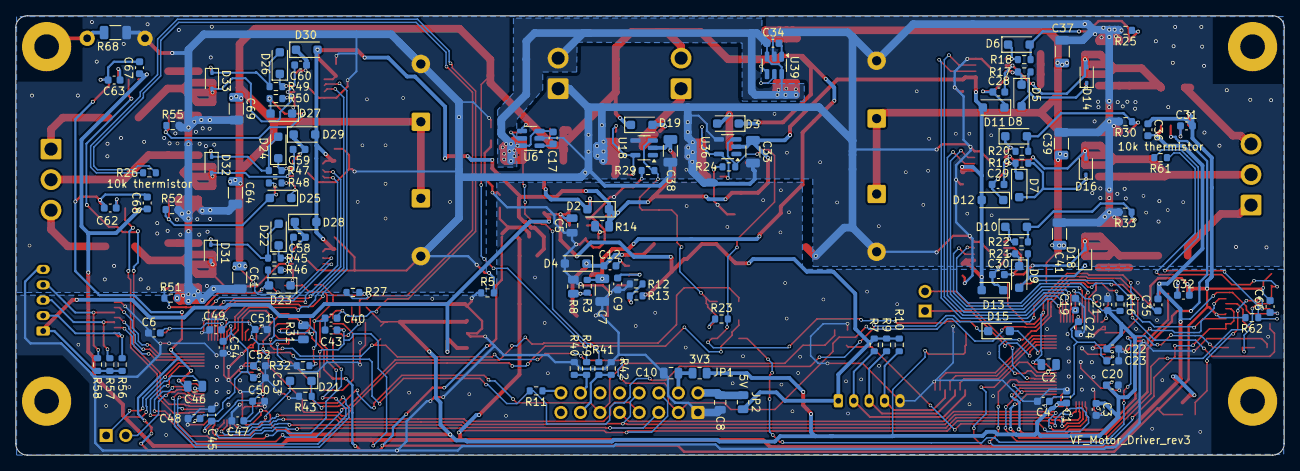
[picture p28: board VF_Motor_Driver.kicad_pcb from below]

Board: 2 copper layers, 164.6 x 57.0 mm, 234 parts (137 on the bottom side), 141 nets.
