virtual-fly/VF_MOTOR_DRIVER/(notices)

Notices in the files:
VF_Motor_Driver_rev2/VF_Motor_Driver.kicad_pcb:
Copyright (c) 2025 VirtualFly S.L. Licensed under GNU GPL v3.
